Graduation-Project-TU/Blue-Green-OptiCom/Documentation/PCB/Receiver.jpeg

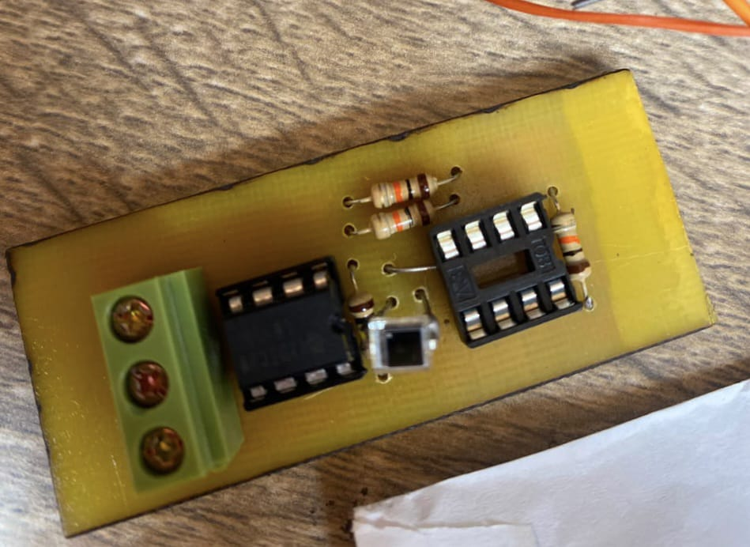
Documentation/PCB/Receiver.jpeg
