Graduation-Project-TU/Blue-Green-OptiCom/(list of files, drawings)

Other design files:
Simulation/Proteus/SSMLEDDRIVER.pdsprj
