Graduation-Project-TU/Blue-Green-OptiCom/(commit log)

2026-04-18 feat: add sensor reading and UART transmission for JSN-SR04T and DS18B20
2026-04-18 feat: add UART receiver and data parsing for sensor telemetry
2026-04-25 Fix: Update Serial2 initialization to specify RX/TX pins to resolve communication issue between boards
2026-05-05 feat: implement RMT transmitter with Manchester encoding and sensor logic
2026-05-07 feat(tx): increase Manchester data rate by reducing half-bit duration
    - Reduce MANCHESTER_HALF_BIT_US to 10µs
    - Achieve higher transmission rate (~50 kbps using Manchester encoding)
    - Keep RMT configuration unchanged
    - Maintain existing payload structure and frame format
2026-05-07 feat(rx): support higher Manchester data rate (10µs half-bit timing)
    - Update MANCHESTER_HALF_BIT_US to match transmitter timing
    - Ensure correct decoding at increased data rate (~50 kbps)
    - Maintain existing frame synchronization and preamble detection logic
    [receiver_node_rmt_rx.ino]
2026-05-14 refactor: restructure project hierarchy and organize system nodes
    - Organize project files into a structured hierarchy for better maintainability.
    - Create '01-On-Air-System' for ESP-NOW and RF-based communication.
    - Create '02-Underwater-System' with subfolders for UART and RMT (Manchester) encoding methods.
    - Initialize '03-Hybrid-System' for cross-medium integration.
2026-05-14 feat(on-air): implement ESP-NOW transmitter with JSN-SR04T sensor
    - Configure JSN-SR04T ultrasonic sensor for distance measurement.
    - Initialize ESP-NOW protocol for peer-to-peer wireless transmission.
    - Implement data structure (struct) to broadcast distance readings.
2026-05-14 feat(hybrid): implement hybrid gateway receiver for cross-medium data relay
    - Establish a hybrid bridge between underwater optical data and on-air RF signals.
    - Configure RMT interface to capture incoming underwater sensor readings.
    - Integrate ESP-NOW logic to re-broadcast processed data to surface stations.
2026-05-14 Refactor: Implement Dual-Core FreeRTOS with Task-Queue Architecture.
    - Core 0 - Data Acquisition: Runs sensorReaderTask to poll DS18B20 and Ultrasonic sensor and dataFormatterTask to convert raw data into CSV strings.
    - Core 1 - Transmission: Dedicated rmtTransmitterTask for Manchester encoding and RMT optical transmission to ensure precise timing.
    - Queue-Driven Flow: Used xMeasurementQueue for sensor data transfer and xPayloadQueue for passing formatted buffers to the transmitter.
2026-07-24 refactor: reorganize repository and add project documentation assets
    [SSMLEDDRIVER.pdsprj]
